stahta01/capes/pocketbeagle/TechLab/kicad/TechLab.kicad_pcb

## KiCad design pocketbeagle/TechLab/kicad/TechLab.kicad_pcb (2025-05-31)

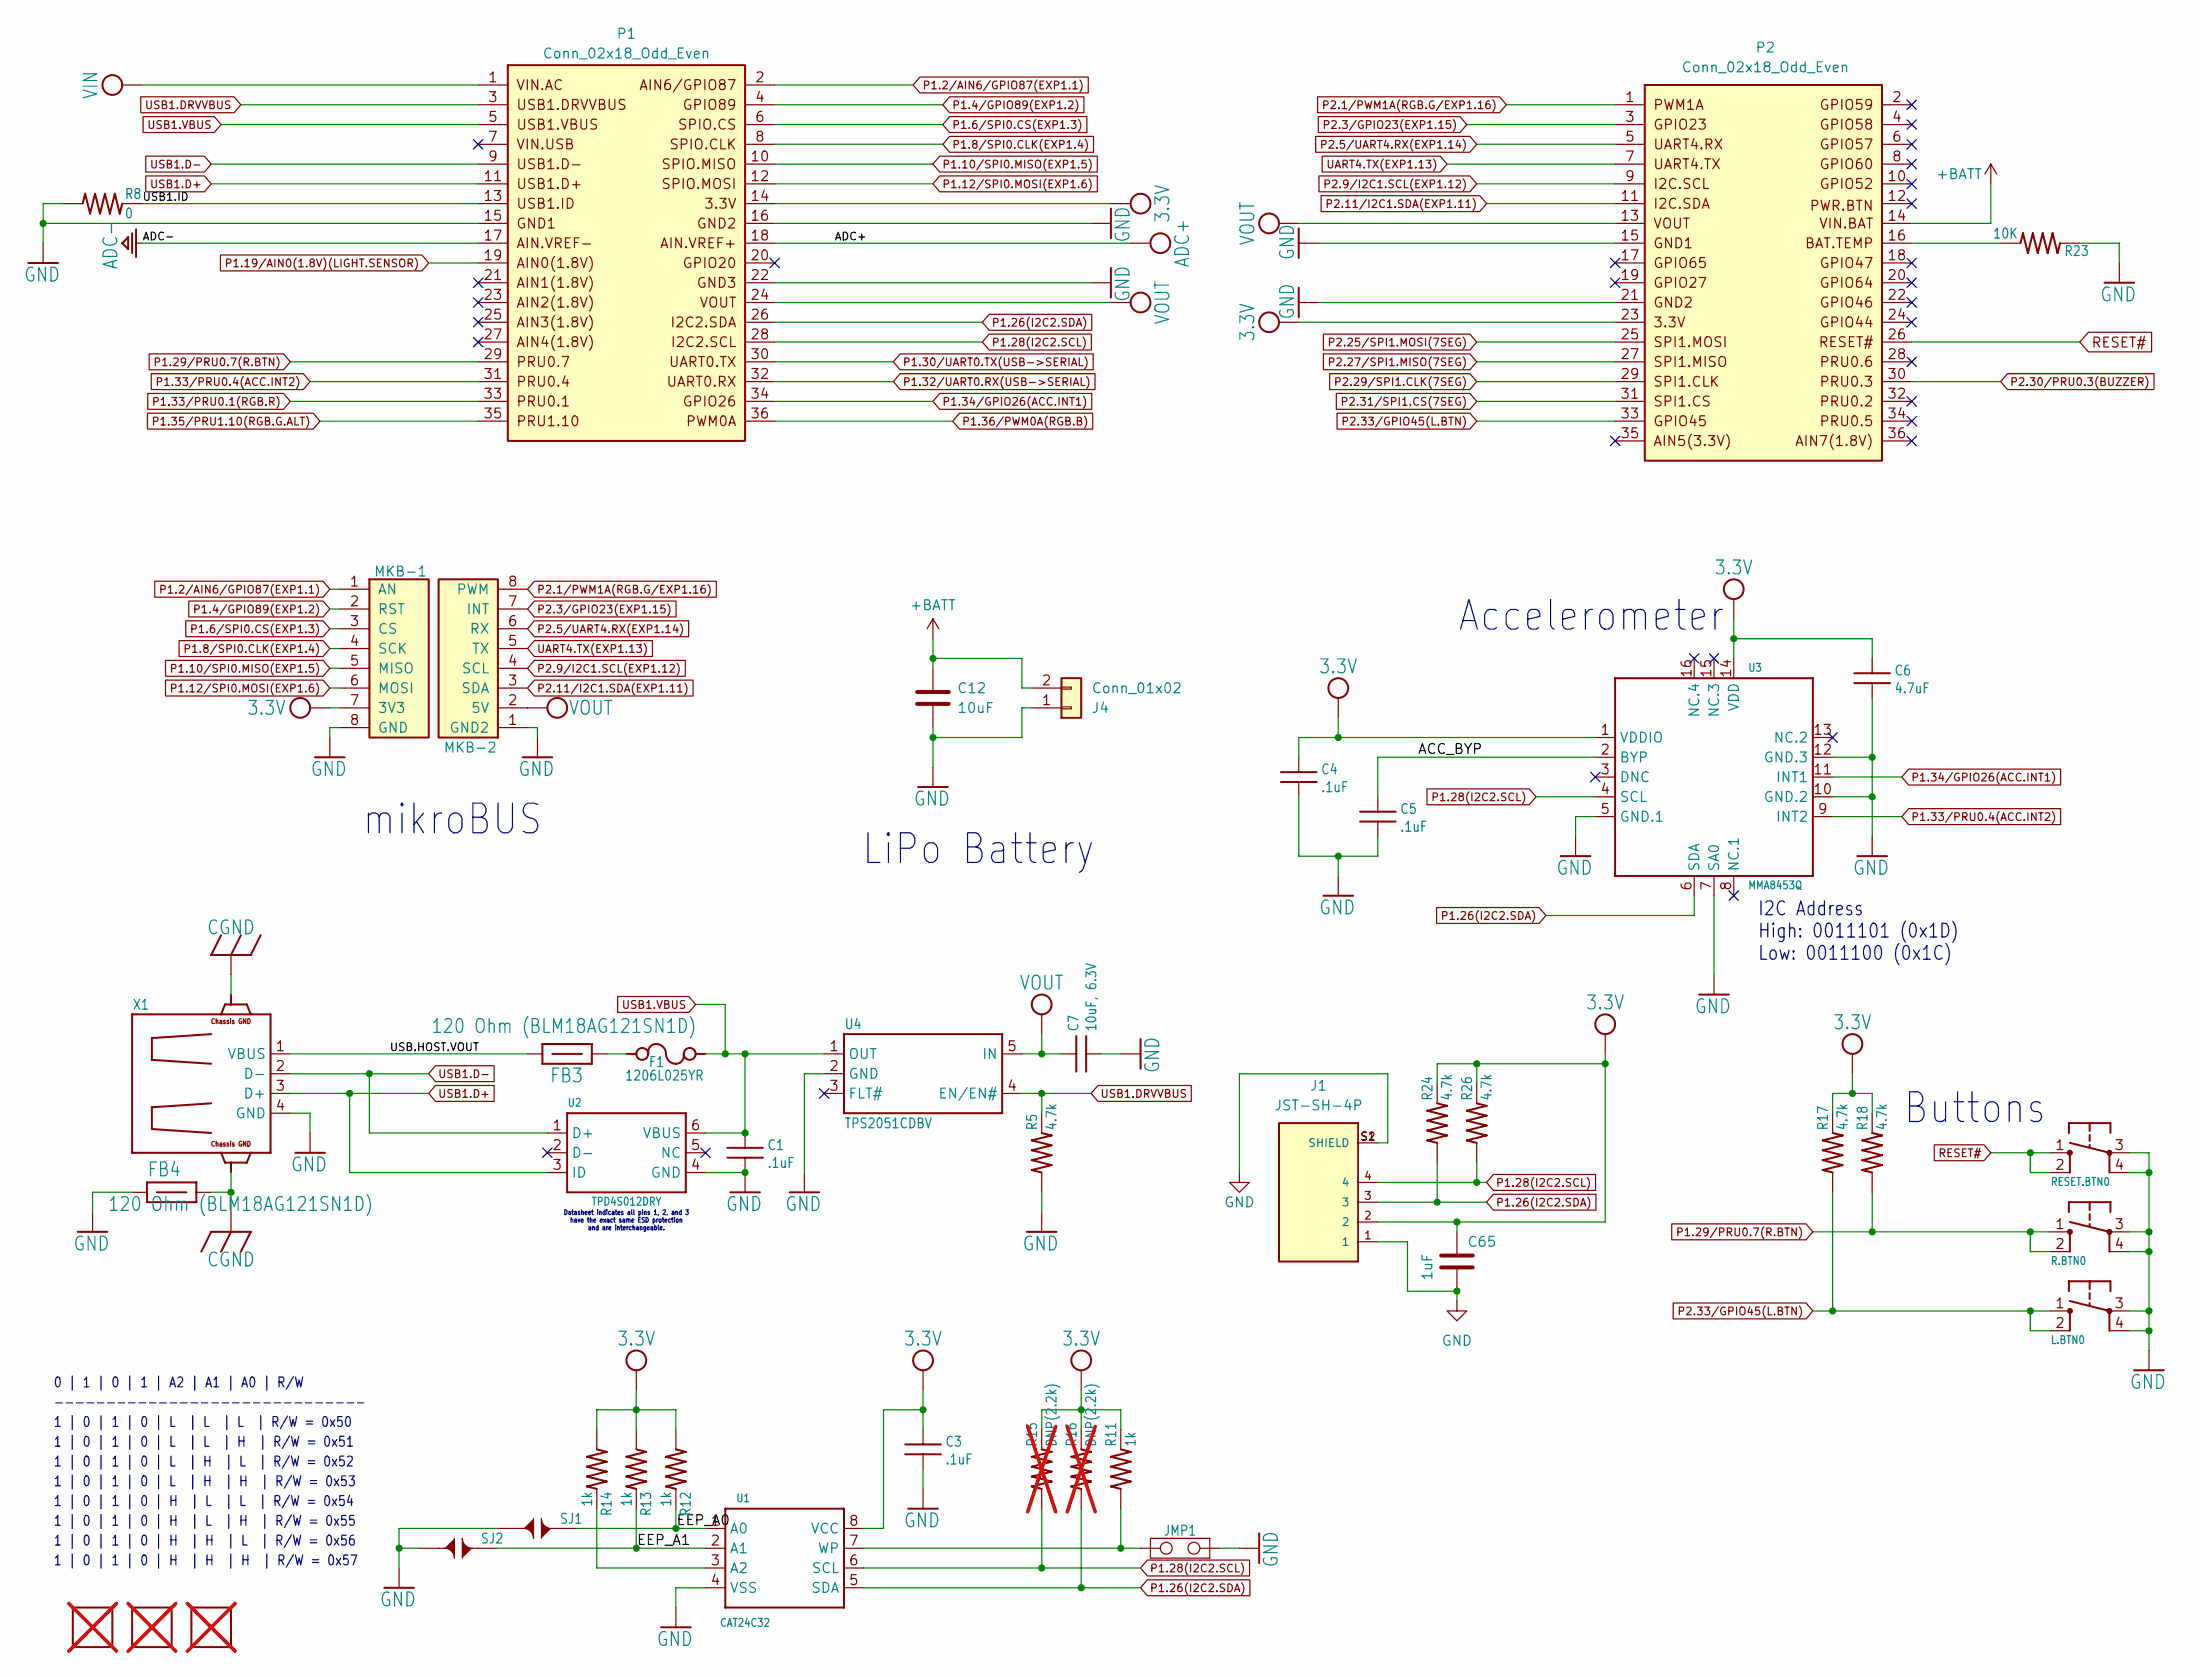
[picture p1: schematic TechLab_Page1.kicad_sch, PocketBeagle TechLab]

Parts:
C1, C3, C4, C5: .1uF; 0402; MPN C1005X7R1H104K050BB
C6: 4.7uF; 0402; MPN C1005X5R1A475M050BC
C7: 10uF, 6.3V; 0805; MPN CC0805KKX5R5BB106
C12: 10uF; C_0603_1608Metric
C65: 1uF; C_0603_1608Metric_Pad1.08x0.95mm_HandSolder
F1: 1206L025YR; 1206; MPN 1206L025YR
FB3, FB4: 120 Ohm (BLM18AG121SN1D); 0603; MPN BLM18AG121SN1D
FUD1, FUD2, FUD3: FIDUCIAL; FIDUCIAL_40MIL; not fitted
J1: JST-SH-4P
J4: Conn_01x02; BAT_JST_PH
JMP1: JUMPER-(X2)
L.BTN0: TACTILE.SWITCH-6MM; 6MM_TACTILE-SWITCH; MPN 1301.9315.24
MKB-1, MKB-2: Conn_01x08; PinSocket_1x08_P2.54mm_Vertical_SMD_Pin1Right; MPN SSM-108-L-SV
P1, P2: Conn_02x18_Odd_Even; PinHeader_2x18_P2.54mm_Vertical_SMD; MPN 61003621121
R5, R17, R18, R24, R26: 4.7k; 0402; MPN CRG0402F4K7
R8: 0; 0402; MPN RC0402JR-070RL
R11, R12, R13, R14: 1k; 0402; MPN 1-1622826-8
R15, R16: DNP(2.2k); 0402; not fitted
R23: 10K; 0402; MPN RC0402FR-075K1L
R.BTN0: TACTILE.SWITCH-6MM; 6MM_TACTILE-SWITCH; MPN 1301.9315.24
RESET.BTN0: TACTILE.SWITCH-3X3.5MM; 3X3.5MM-TACTILE-SWITCH; MPN TS23-46-06-BK-160-SMT-TR
SJ1, SJ2: SOLDER.JOINT-(INCH)-0402; SOLDER.JOINT(0402)
U1: CAT24C32; UDFN8,2X3(ON-SEMI); MPN CAT24C32HU4I-GT3
U2: TPD4S012DRY; SON-6(TI)-DRY; MPN TPD4S012DRYR
U3: MMA8453Q; QFN-16-(MMA8453Q); MPN MMA8491QR1
U4: TPS2051CDBV; SOT23-5(TI-DBV); MPN TPS2051CDBVR
X1: 292303-1; MPN 292303-1

Connections:
3.3V: C3.1, C4.1, C6.1, C65.1, J1.2, MKB-1.7 (3V3), P1.14, P2.23, R11.2, R12.1, R13.1, R14.1, R15.2, R16.2, R17.2, R18.2, R24.2, R26.2, U1.8 (VCC), U3.1 (VDDIO), U3.14 (VDD); also elsewhere on the board
+BATT: C12.1, J4.2, P2.14
/Page1/ACC_BYP: C5.1, U3.2 (BYP)
/Page1/EEP_A0: R12.2, SJ1.2, U1.1 (A0)
/Page1/EEP_A1: R13.2, SJ2.2, U1.2 (A1)
/Page1/USB1.ID: P1.13, R8.2
/Page1/USB.HOST.VOUT: FB3.1, X1.1 (VBUS)
ADC+: P1.18; also elsewhere on the board
ADC-: P1.17; also elsewhere on the board
CGND: FB4.2, X1.C1 (CG@6), X1.C2 (CG@5); also elsewhere on the board
GND: C1.2, C3.2, C4.2, C5.2, C6.2, C7.2, C12.2, C65.2, FB4.1, J1.1, J1.S1 (SHIELD), J1.S2 (SHIELD), J4.1, JMP1.2, L.BTN0.3, L.BTN0.4, MKB-1.8 (GND), MKB-2.1 (GND2), P1.15, P1.16, P1.22, P2.15, P2.21, R5.1, R8.1, R23.1, R.BTN0.3, R.BTN0.4, RESET.BTN0.3, RESET.BTN0.4, SJ1.1, SJ2.1, U1.4 (VSS), U2.4 (GND), U3.5 (GND.1), U3.7 (SA0), U3.10 (GND.2), U3.12 (GND.3), U4.2 (GND), X1.4 (GND); also elsewhere on the board
unnamed: F1.1, FB3.2
unnamed: P2.16, R23.2
unnamed: R14.2, U1.3 (A2)
unnamed: JMP1.1, R11.1, U1.7 (WP)
P1.2/AIN6/GPIO87(EXP1.1): MKB-1.1 (AN), P1.2
P1.4/GPIO89(EXP1.2): MKB-1.2 (RST), P1.4
P1.6/SPI0.CS(EXP1.3): MKB-1.3 (CS), P1.6
P1.8/SPI0.CLK(EXP1.4): MKB-1.4 (SCK), P1.8
P1.10/SPI0.MISO(EXP1.5): MKB-1.5 (MISO), P1.10
P1.12/SPI0.MOSI(EXP1.6): MKB-1.6 (MOSI), P1.12
P1.19/AIN0(1.8V)(LIGHT.SENSOR): P1.19; also elsewhere on the board
P1.26(I2C2.SDA): J1.3, P1.26, R16.1, R24.1, U1.5 (SDA), U3.6 (SDA)
P1.28(I2C2.SCL): J1.4, P1.28, R15.1, R26.1, U1.6 (SCL), U3.4 (SCL)
P1.29/PRU0.7(R.BTN): P1.29, R18.1, R.BTN0.1, R.BTN0.2
P1.30/UART0.TX(USB->SERIAL): P1.30; also elsewhere on the board
P1.32/UART0.RX(USB->SERIAL): P1.32; also elsewhere on the board
P1.33/PRU0.1(RGB.R): P1.33; also elsewhere on the board
P1.33/PRU0.4(ACC.INT2): P1.31, U3.9 (INT2)
P1.34/GPIO26(ACC.INT1): P1.34, U3.11 (INT1)
P1.35/PRU1.10(RGB.G.ALT): P1.35; also elsewhere on the board
P1.36/PWM0A(RGB.B): P1.36; also elsewhere on the board
P2.1/PWM1A(RGB.G/EXP1.16): MKB-2.8 (PWM), P2.1; also elsewhere on the board
P2.3/GPIO23(EXP1.15): MKB-2.7 (INT), P2.3
P2.5/UART4.RX(EXP1.14): MKB-2.6 (RX), P2.5
P2.9/I2C1.SCL(EXP1.12): MKB-2.4 (SCL), P2.9
P2.11/I2C1.SDA(EXP1.11): MKB-2.3 (SDA), P2.11
P2.25/SPI1.MOSI(7SEG): P2.25; also elsewhere on the board
P2.27/SPI1.MISO(7SEG): P2.27; also elsewhere on the board
P2.29/SPI1.CLK(7SEG): P2.29; also elsewhere on the board
P2.30/PRU0.3(BUZZER): P2.30; also elsewhere on the board
P2.31/SPI1.CS(7SEG): P2.31; also elsewhere on the board
P2.33/GPIO45(L.BTN): L.BTN0.1, L.BTN0.2, P2.33, R17.1
RESET#: P2.26, RESET.BTN0.1, RESET.BTN0.2; also elsewhere on the board
UART4.TX(EXP1.13): MKB-2.5 (TX), P2.7
USB1.D+: P1.11, U2.3 (ID), X1.3 (D+)
USB1.D-: P1.9, U2.1 (D+), X1.2 (D-)
USB1.DRVVBUS: P1.3, R5.2, U4.4 (EN/EN#)
USB1.VBUS: C1.1, F1.2, P1.5, U2.6 (VBUS), U4.1 (OUT)
VIN: P1.1; also elsewhere on the board
VOUT: C7.1, MKB-2.2 (5V), P1.24, P2.13, U4.5 (IN); also elsewhere on the board

Notes on the sheet:
Accelerometer
Buttons
1 | 0 | 1 | 0 | H | L | L | R/W = 0x54
1 | 0 | 1 | 0 | L | H | H | R/W = 0x53
1 | 0 | 1 | 0 | H | H | H | R/W = 0x57
LiPo Battery
I2C Address High: 0011101 (0x1D) Low: 0011100 (0x1C)
mikroBUS
1 | 0 | 1 | 0 | H | H | L | R/W = 0x56
1 | 0 | 1 | 0 | H | L | H | R/W = 0x55
0 | 1 | 0 | 1 | A2 | A1 | A0 | R/W
1 | 0 | 1 | 0 | L | L | L | R/W = 0x50
1 | 0 | 1 | 0 | L | L | H | R/W = 0x51
1 | 0 | 1 | 0 | L | H | L | R/W = 0x52
Datasheet indicates all pins 1, 2, and 3 have the exact same ESD protection and are interchangeable.
------------------------------

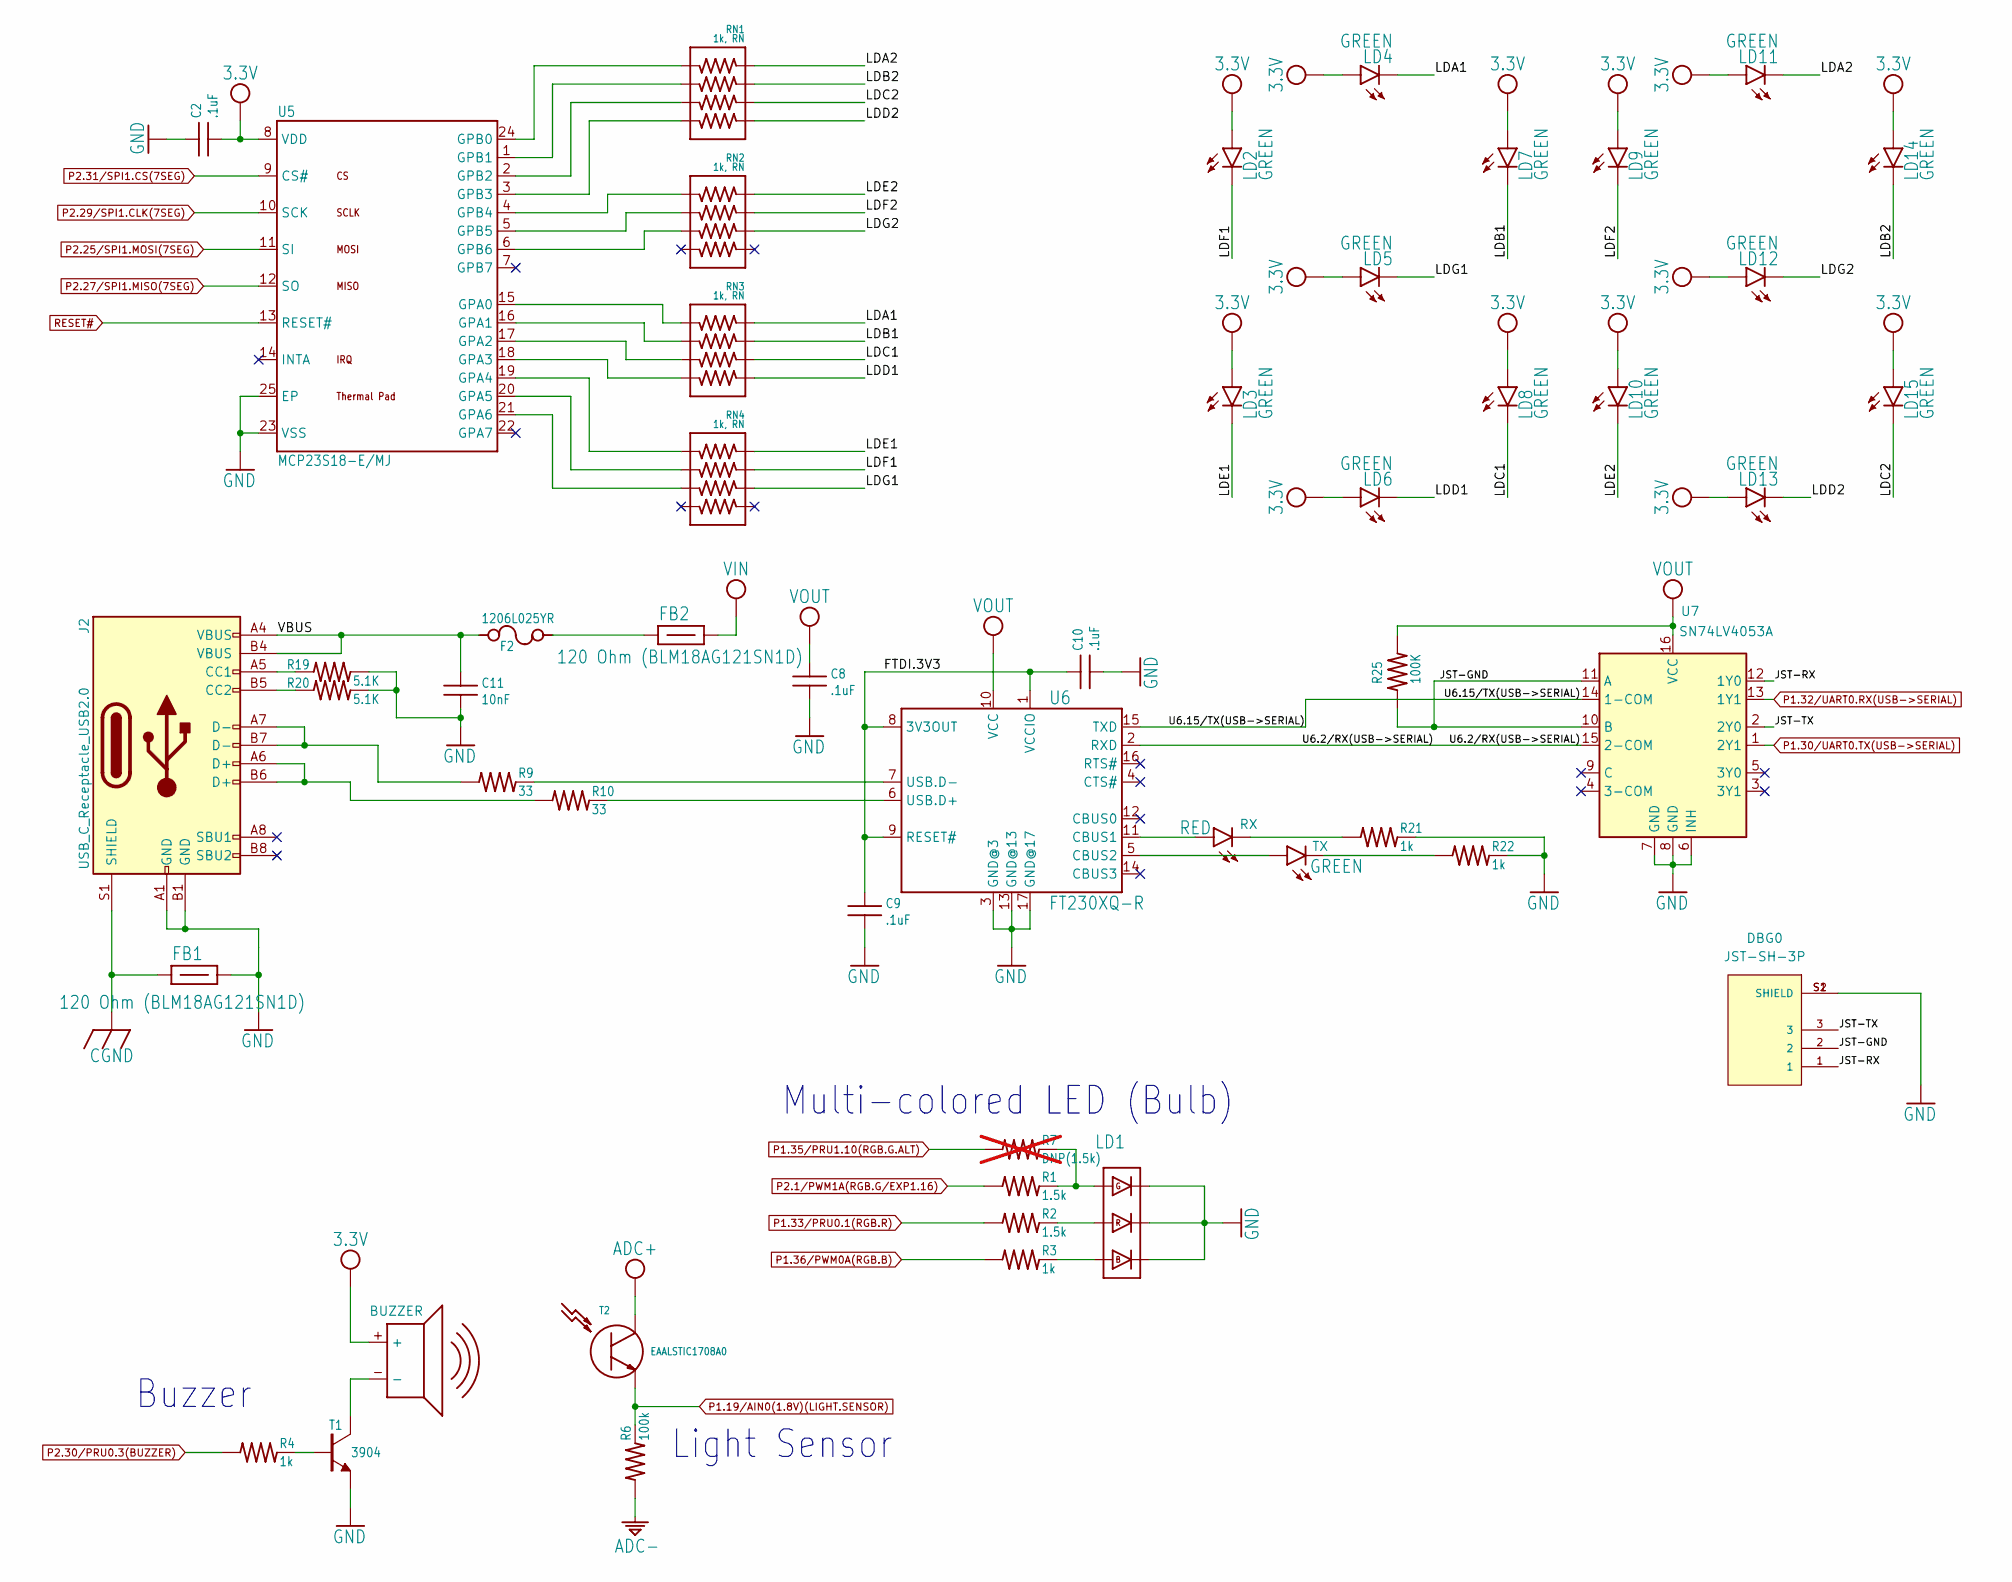
[picture p2: schematic TechLab_Page2.kicad_sch, PocketBeagle TechLab]

Parts:
BUZZER0: SMD-140035H; MPN SMT-1427-S-5V-HT-R
C2, C8, C9, C10: .1uF; 0402; MPN C1005X7R1H104K050BB
C11: 10nF; 0402; MPN GCM155R71H103KA55D
DBG0: JST-SH-3P; MPN SM03B-SRSS-TB
F2: 1206L025YR; 1206; MPN 1206L025YR
FB1, FB2: 120 Ohm (BLM18AG121SN1D); 0603; MPN BLM18AG121SN1D
J2: USB_C_Receptacle_USB2.0; USB_C_Receptacle_GCT_USB4105-xx-A_16P_TopMnt_Horizontal; MPN USB4105-GF-A
LD1: JNS-5050RGB; LED_RGB_5050; MPN SMD-LX5050RGB-TR
LD2, LD3, LD4, LD5, LD6, LD7, LD8, LD9, LD10, LD11, LD12, LD13, LD14, LD15: GREEN; 0805-LED; MPN SML-LXT0805GW-TR
R1, R2: 1.5k; 0402; MPN CR0402-FX-1501GLF
R3, R4, R21, R22: 1k; 0402; MPN 1-1622826-8
R6: 100k; 0402; MPN CRG0402F100K
R7: DNP(1.5k); 0402; not fitted
R9, R10: 33; 0402; MPN CR0402-FX-1501GLF
R19, R20: 5.1K; 0402; MPN RC0402FR-075K1L
R25: 100K; 0402; MPN CRG0402F100K
RN1, RN2, RN3, RN4: 1k, RN; RN0804; MPN CAY10-102J4LF
RX0: RED; 0805-LED; MPN 598-8110-107F
T1: 3904; SOT23; MPN MMBT3904-TP
T2: EAALSTIC1708A0; MPN IN-S63DTLS
TX0: GREEN; 0805-LED; MPN SML-LXT0805GW-TR
U5: MCP23S18-E/MJ; QFN24-MJ-0.5-4X4MM; MPN MCP23S18-E/MJ
U6: FT230XQ-R; QFN16-0.65-4X4MM; MPN FT230XQ-R
U7: SN74LV4053A; SOT-23-THN-16; MPN SN74LV4053ADYYR

Connections:
3.3V: BUZZER0.+, C2.2, LD2.A, LD3.A, LD4.A, LD5.A, LD6.A, LD7.A, LD8.A, LD9.A, LD10.A, LD11.A, LD12.A, LD13.A, LD14.A, LD15.A, U5.8 (VDD); also elsewhere on the board
/Page2/FTDI.3V3: C9.1, C10.1, U6.1 (VCCIO), U6.8 (3V3OUT), U6.9 (RESET#)
/Page2/JST-GND: DBG0.2, R25.1, U7.10 (B), U7.11 (A)
/Page2/JST-RX: DBG0.1, U7.12 (1Y0)
/Page2/JST-TX: DBG0.3, U7.2 (2Y0)
/Page2/LDA1: LD4.K, RN3.1
/Page2/LDA2: LD11.K, RN1.1
/Page2/LDB1: LD7.K, RN3.2
/Page2/LDB2: LD14.K, RN1.2
/Page2/LDC1: LD8.K, RN3.3
/Page2/LDC2: LD15.K, RN1.3
/Page2/LDD1: LD6.K, RN3.4
/Page2/LDD2: LD13.K, RN1.4
/Page2/LDE1: LD3.K, RN4.1
/Page2/LDE2: LD10.K, RN2.1
/Page2/LDF1: LD2.K, RN4.2
/Page2/LDF2: LD9.K, RN2.2
/Page2/LDG1: LD5.K, RN4.3
/Page2/LDG2: LD12.K, RN2.3
/Page2/U6.2/RX(USB->SERIAL): U6.2 (RXD), U7.15 (2-COM)
/Page2/U6.15/TX(USB->SERIAL): U6.15 (TXD), U7.14 (1-COM)
/Page2/VBUS: C11.1, F2.1, J2.A4 (VBUS), J2.B4 (VBUS)
ADC+: T2.1 (C); also elsewhere on the board
ADC-: R6.1; also elsewhere on the board
CGND: FB1.1, J2.S1 (SHIELD); also elsewhere on the board
GND: C2.1, C8.2, C9.2, C10.2, C11.2, DBG0.S1 (SHIELD), DBG0.S2 (SHIELD), FB1.2, J2.A1 (GND), J2.B1 (GND), LD1.4(-), LD1.5(-), LD1.6(-), R19.2, R20.2, R21.2, R22.2, T1.2 (E), U5.23 (VSS), U5.25 (EP), U6.3 (GND@3), U6.13 (GND@13), U6.17 (GND@17), U7.6 (INH), U7.7 (GND), U7.8 (GND); also elsewhere on the board
unnamed: F2.2, FB2.1
unnamed: J2.A5 (CC1), R19.1
unnamed: J2.B5 (CC2), R20.1
unnamed: J2.A6 (D+), J2.B6 (D+), R10.1
unnamed: J2.A7 (D-), J2.B7 (D-), R9.1
unnamed: LD1.1(+), R3.2
unnamed: LD1.2(+), R2.2
unnamed: LD1.3(+), R1.2, R7.2
unnamed: R21.1, RX0.K
unnamed: R22.1, TX0.K
unnamed: R4.2, T1.1 (B)
unnamed: BUZZER0.-, T1.3 (C)
unnamed: RN3.8, U5.15 (GPA0)
unnamed: RN3.7, U5.16 (GPA1)
unnamed: RN3.6, U5.17 (GPA2)
unnamed: RN3.5, U5.18 (GPA3)
unnamed: RN4.8, U5.19 (GPA4)
unnamed: RN4.7, U5.20 (GPA5)
unnamed: RN4.6, U5.21 (GPA6)
unnamed: RN1.8, U5.24 (GPB0)
unnamed: RN1.7, U5.1 (GPB1)
unnamed: RN1.6, U5.2 (GPB2)
unnamed: RN1.5, U5.3 (GPB3)
unnamed: RN2.8, U5.4 (GPB4)
unnamed: RN2.7, U5.5 (GPB5)
unnamed: RN2.6, U5.6 (GPB6)
unnamed: RX0.A, U6.11 (CBUS1)
unnamed: TX0.A, U6.5 (CBUS2)
unnamed: R10.2, U6.6 (USB.D+)
unnamed: R9.2, U6.7 (USB.D-)
P1.19/AIN0(1.8V)(LIGHT.SENSOR): R6.2, T2.2 (E); also elsewhere on the board
P1.30/UART0.TX(USB->SERIAL): U7.1 (2Y1); also elsewhere on the board
P1.32/UART0.RX(USB->SERIAL): U7.13 (1Y1); also elsewhere on the board
P1.33/PRU0.1(RGB.R): R2.1; also elsewhere on the board
P1.35/PRU1.10(RGB.G.ALT): R7.1; also elsewhere on the board
P1.36/PWM0A(RGB.B): R3.1; also elsewhere on the board
P2.1/PWM1A(RGB.G/EXP1.16): R1.1; also elsewhere on the board
P2.25/SPI1.MOSI(7SEG): U5.11 (SI); also elsewhere on the board
P2.27/SPI1.MISO(7SEG): U5.12 (SO); also elsewhere on the board
P2.29/SPI1.CLK(7SEG): U5.10 (SCK); also elsewhere on the board
P2.30/PRU0.3(BUZZER): R4.1; also elsewhere on the board
P2.31/SPI1.CS(7SEG): U5.9 (CS#); also elsewhere on the board
RESET#: U5.13 (RESET#); also elsewhere on the board
VIN: FB2.2; also elsewhere on the board
VOUT: C8.1, R25.2, U6.10 (VCC), U7.16 (VCC); also elsewhere on the board

Notes on the sheet:
Multi-colored LED (Bulb)
Buzzer
Light Sensor

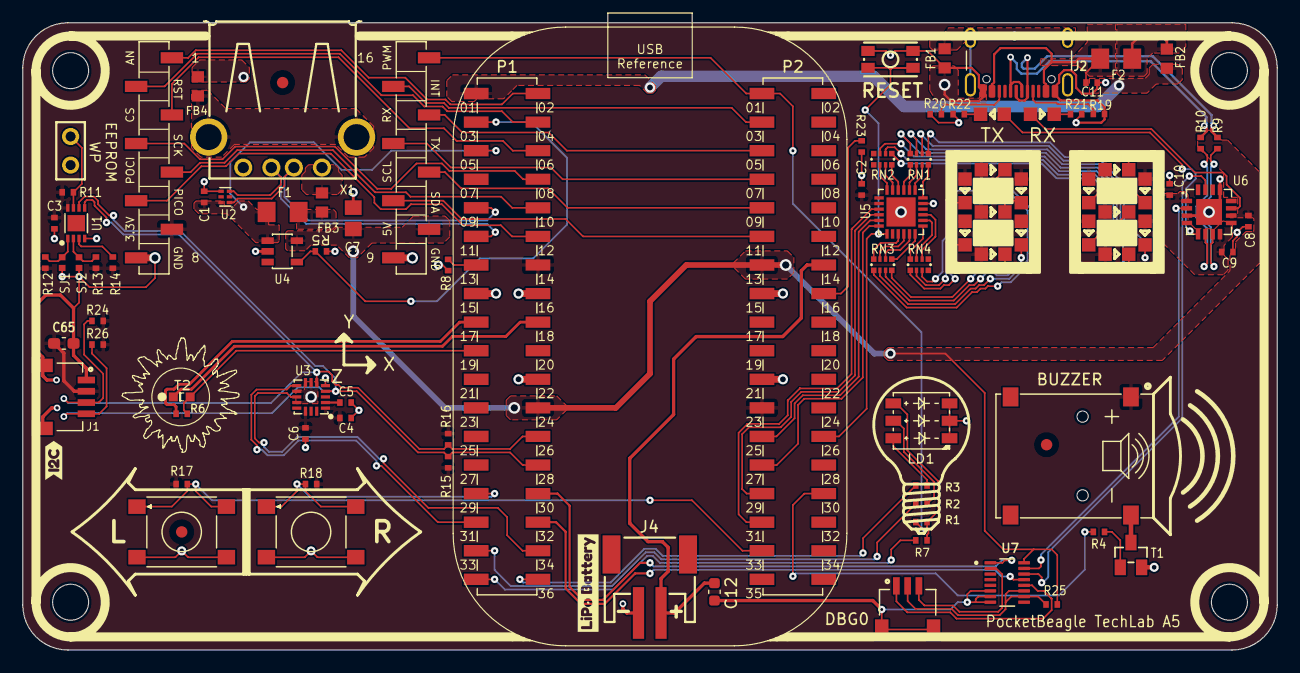
[picture p3: board TechLab.kicad_pcb from above]

Board: 2 copper layers, 111.5 x 55.8 mm, 100 parts (0 on the bottom side), 102 nets.

Other parts of the board:
@HOLE0, @HOLE1, @HOLE2, @HOLE3: (no value)
kibuzzard-68396DBE: G***; kibuzzard-68396DBE
kibuzzard-68396DE6: G***; kibuzzard-68396DE6
