stahta01/capes/(commit log)

2025-05-27 Update cape header pins slinkscreen front and back
    [TechLab.kicad_pcb]
2025-05-30 Add I2C port
    [TechLab.kicad_pcb, TechLab_Page1.kicad_sch]
2025-05-31 Update cape header pin symbol
    [TechLab_Page1.kicad_sch, TechLab_Page2.kicad_sch]
2025-05-31 PCB minor updates
    [TechLab.kicad_pcb]
2025-05-31 Add Techlab Rev A5 gerbers without logo
    [TechLab-B_Cu.gbr, TechLab-B_Mask.gbr, TechLab-B_Paste.gbr, TechLab-B_Silkscreen.gbr, TechLab-Edge_Cuts.gbr, TechLab-F_Cu.gbr, TechLab-F_Mask.gbr, TechLab-F_Paste.gbr]
